h0raz/pcb_etching_machine/construction/Aetzmaschine.FCStd

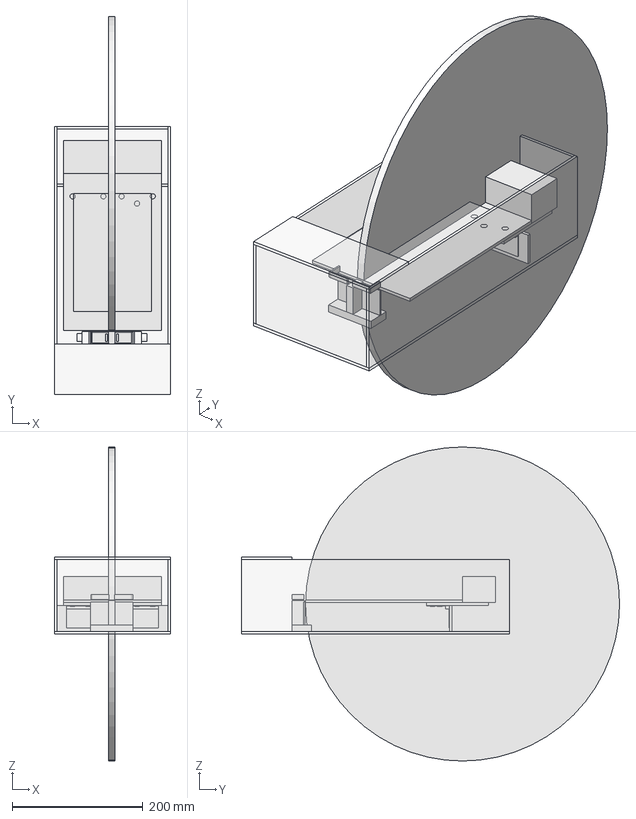
[picture p1: CAD file, 2014-02-27]
construction/Aetzmaschine.FCStd
178.0 x 578.0 x 480.0 mm
Scharnier1
Scharnier2
Ätzboden
Gewicht-Boden1
Gewicht
Wand001
Wand002
Wand003
Wand004
Boden
Seite
Seite001
Loch-Scharnier1
Loch-Scharnier2
Loch-Scharnier3
Loch-Scharnier4
Loch-Scharnier5
Loch-Scharnier6
Servo Boden
Servo1
Servo2
Servo Zwischenteil
Deckel
Heizungsboden
Servo Halter
Winkel01
Winkel01 (Mirror #2)
