h0raz/pcb_etching_machine/eagle/main.brd

## EAGLE design eagle/main.brd (2014-02-27)

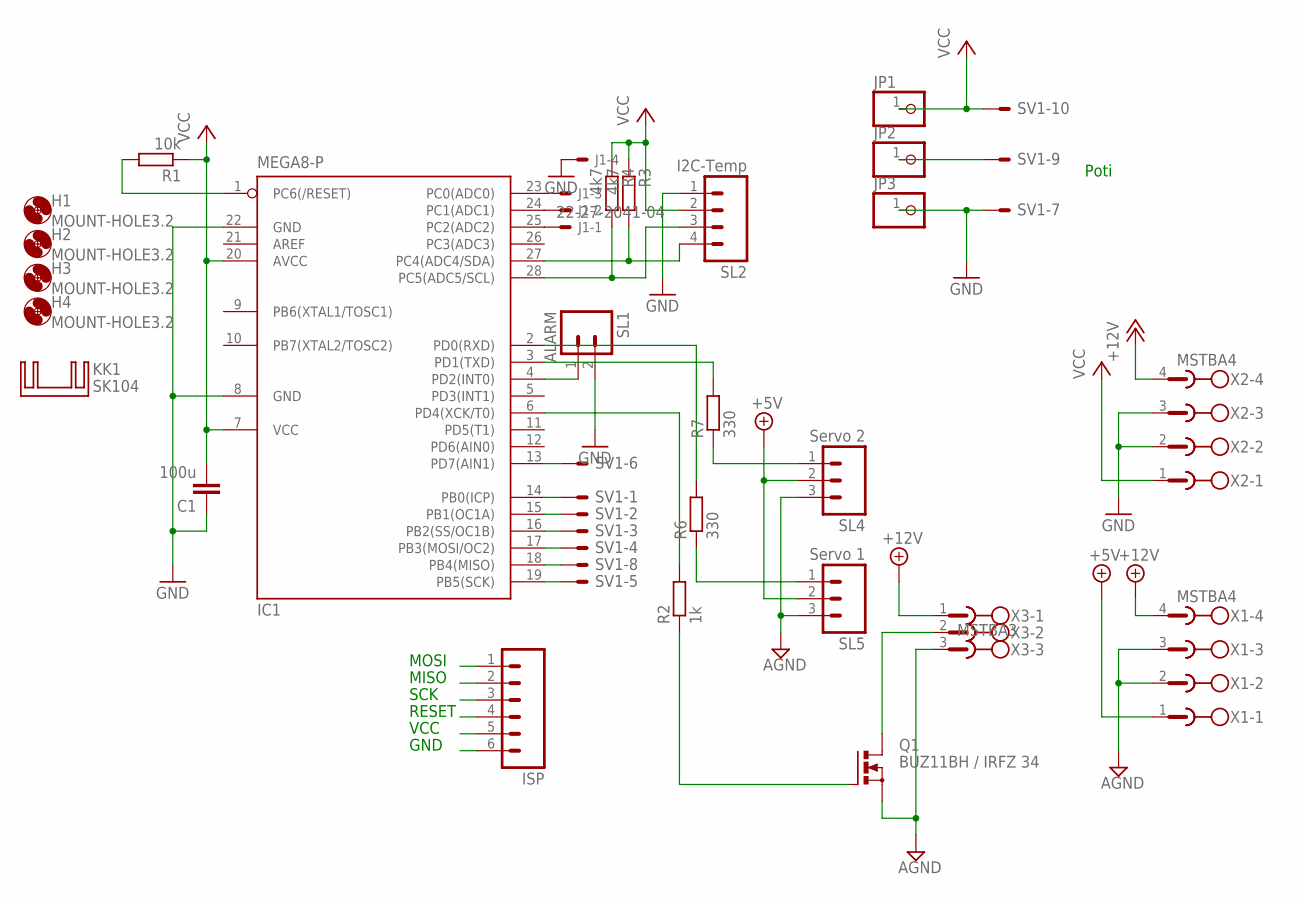
[picture p2: schematic main.sch]

Parts:
C1: 100u; C025-030X050
H1, H2, H3, H4: MOUNT-HOLE3.2; 3,2
IC1: MEGA8-P; DIL28-3
ISP: M06; 06P
J1: 22-27-2041-04; 6410-04
JP1, JP2, JP3: PINHD-1X1; 1X01
KK1: SK104
Q1: BUZ11BH / IRFZ 34; TO220BH
R1: 10k; 0207/10
R2: 1k; 0207/10
R3, R4: 4k7; 0207/10
R6: 330; 0207/10
R7: 330; 0207/12
SL1: ALARM; 02P
SL2: I2C-Temp; 04P
SL4: Servo 2; 03P
SL5: Servo 1; 03P
SV1: ML10E; ML10
X1, X2: MSTBA4
X3: MSTBA3

Connections:
+5V: SL4.2, SL5.2, X1.1
+12V1: X2.4
+12V2: X1.4, X3.1
AGND: Q1.S, SL4.3, SL5.3, X1.2, X1.3, X3.3
GND: C1.1, IC1.8 (GND), IC1.22 (GND), ISP.6, J1.4, JP3.1, SL1.2, SL2.1, SV1.7, X2.2, X2.3
MISO: IC1.18 (PB4(MISO)), ISP.2, SV1.8
MOSI: IC1.17 (PB3(MOSI/OC2)), ISP.1, SV1.4
unnamed: IC1.23 (PC0(ADC0)), J1.3
unnamed: IC1.15 (PB1(OC1A)), SV1.2
unnamed: IC1.16 (PB2(SS/OC1B)), SV1.3
unnamed: IC1.28 (PC5(ADC5/SCL)), R4.2, SL2.3
unnamed: IC1.27 (PC4(ADC4/SDA)), R3.2, SL2.4
unnamed: Q1.D, X3.2
unnamed: Q1.G, R2.1
unnamed: IC1.14 (PB0(ICP)), SV1.1
unnamed: JP2.1, SV1.9
unnamed: IC1.2 (PD0(RXD)), R6.2
unnamed: IC1.6 (PD4(XCK/T0)), R2.2
unnamed: R6.1, SL5.1
unnamed: R7.1, SL4.1
unnamed: IC1.24 (PC1(ADC1)), J1.2
unnamed: IC1.25 (PC2(ADC2)), J1.1
unnamed: IC1.4 (PD2(INT0)), SL1.1
unnamed: IC1.13 (PD7(AIN1)), SV1.6
unnamed: IC1.3 (PD1(TXD)), R7.2
RESET: IC1.1 (PC6(/RESET)), ISP.4, R1.2
SCK: IC1.19 (PB5(SCK)), ISP.3, SV1.5
VCC: C1.2, IC1.7 (VCC), IC1.20 (AVCC), ISP.5, JP1.1, R1.1, R3.1, R4.1, SL2.2, SV1.10, X2.1

Notes on the sheet:
GND
VCC
MOSI
MISO
SCK
RESET
Poti

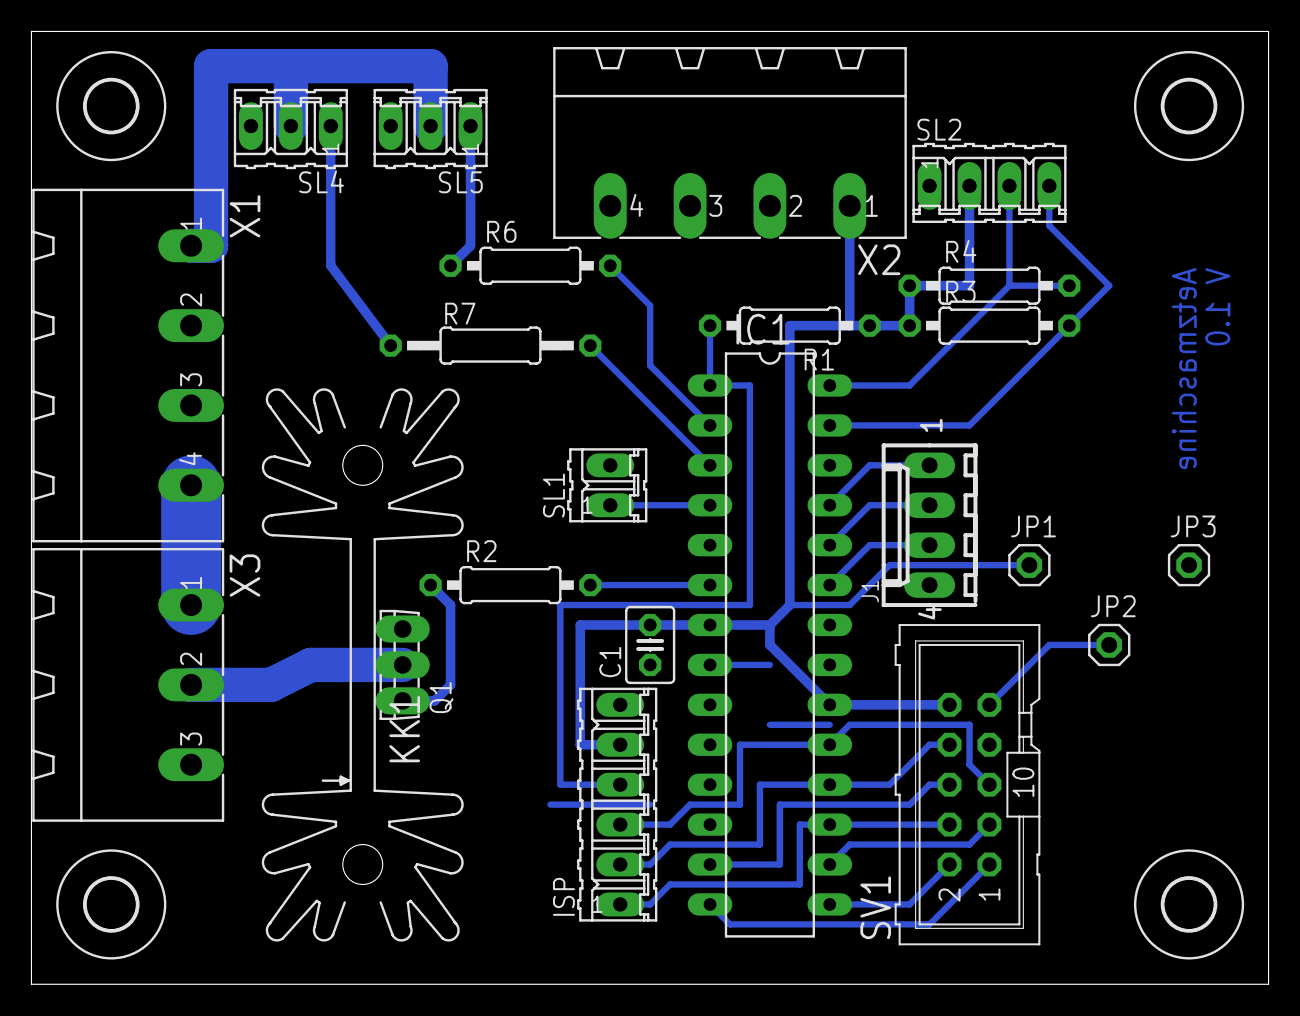
[picture p3: board main.brd from above]

Board: 2 copper layers, 78.7 x 60.6 mm, 27 parts (0 on the bottom side), 27 nets.
